DavisDroneClub/gimbal/README.md

# gimbal
Files for 1-axis servo gimbal

* Pictures: Pictures of gimbal for documentation
* cad: Solidworks CAD files for gimbal
* code: Contains Arduino files for gimbal
* gimbal_tester: Contains python script for testing response of gimbal
