DavisDroneClub/gimbal/Pictures/src/README.txt

All flowcharts created on draw.io and saved as .xml file
