DavisDroneClub/gimbal/Pictures/assem/01.png

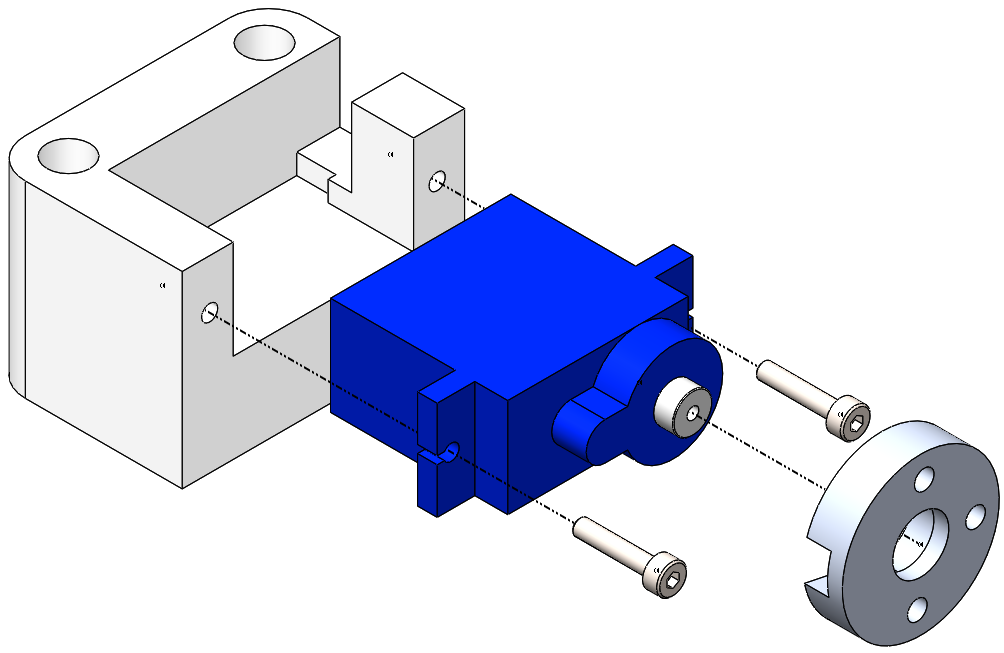
Pictures/assem/01.png
