DavisDroneClub/gimbal/Pictures/assem/02.png

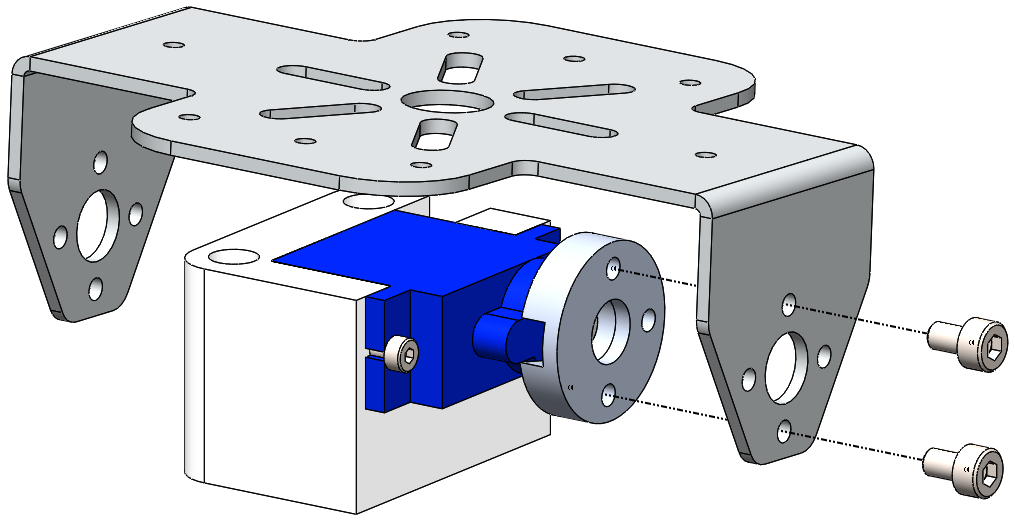
Pictures/assem/02.png
