DavisDroneClub/gimbal/Pictures/assem/03.png

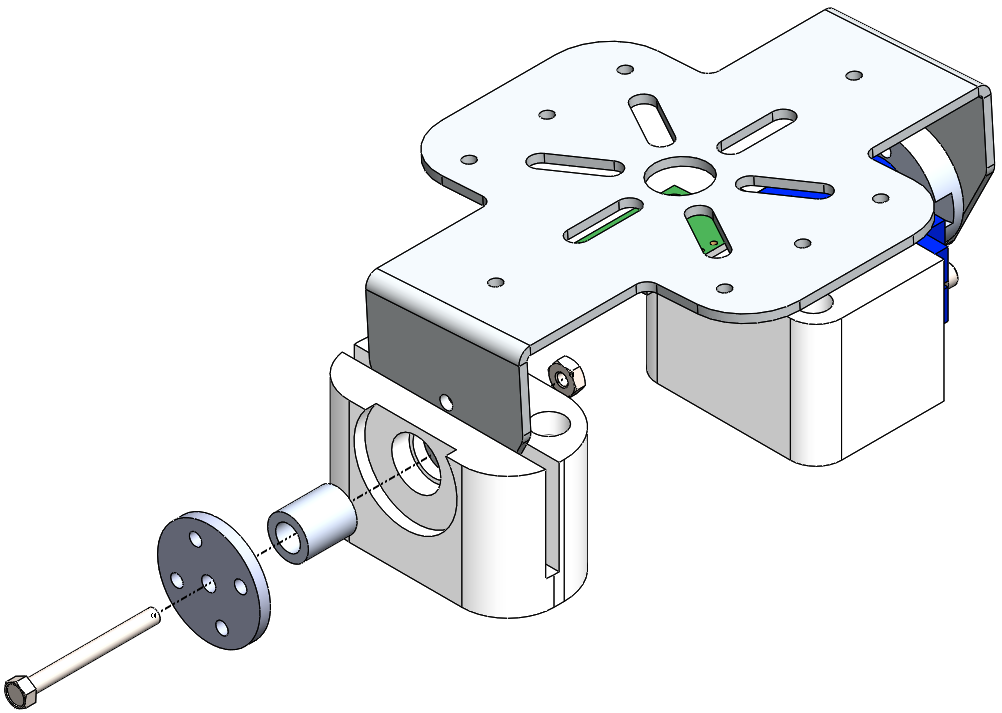
Pictures/assem/03.png
