DavisDroneClub/gimbal/Pictures/assem/04.png

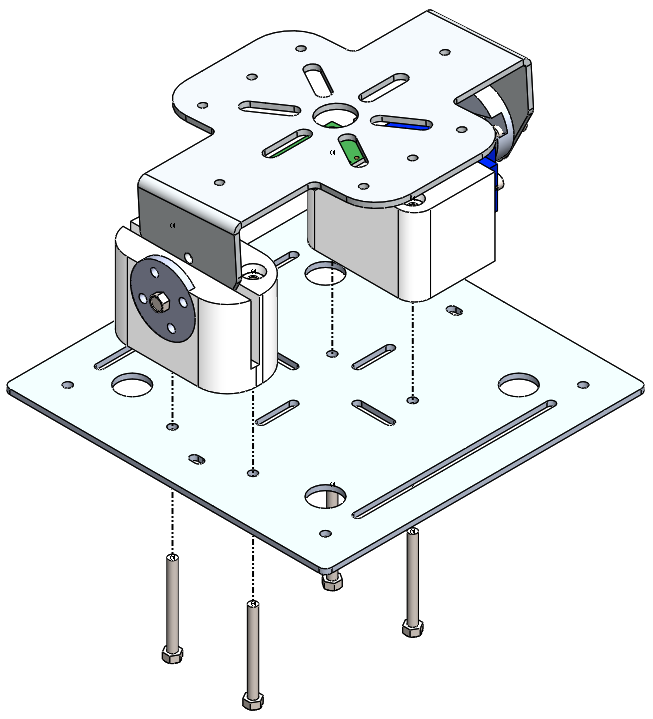
Pictures/assem/04.png
