DavisDroneClub/gimbal/Pictures/assem/05.png

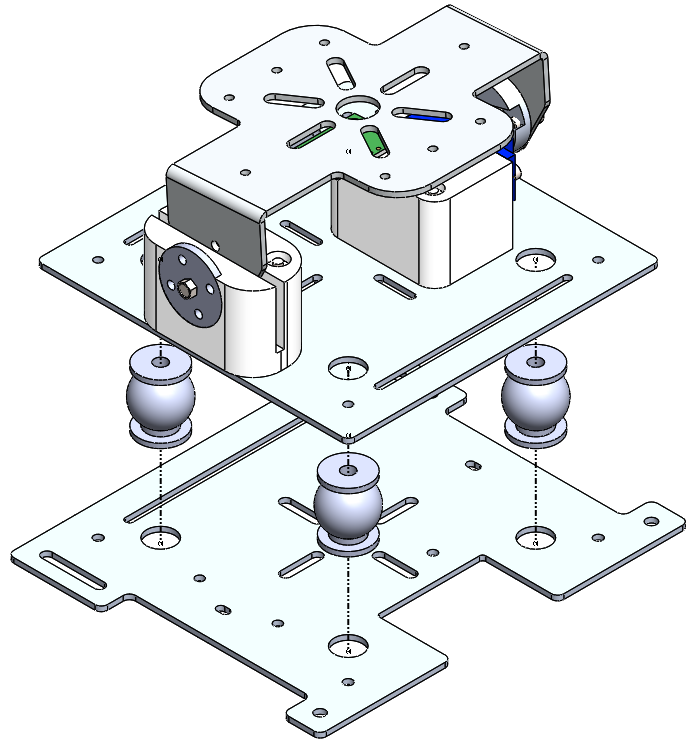
Pictures/assem/05.png
