DavisDroneClub/gimbal/Pictures/assem/06.png

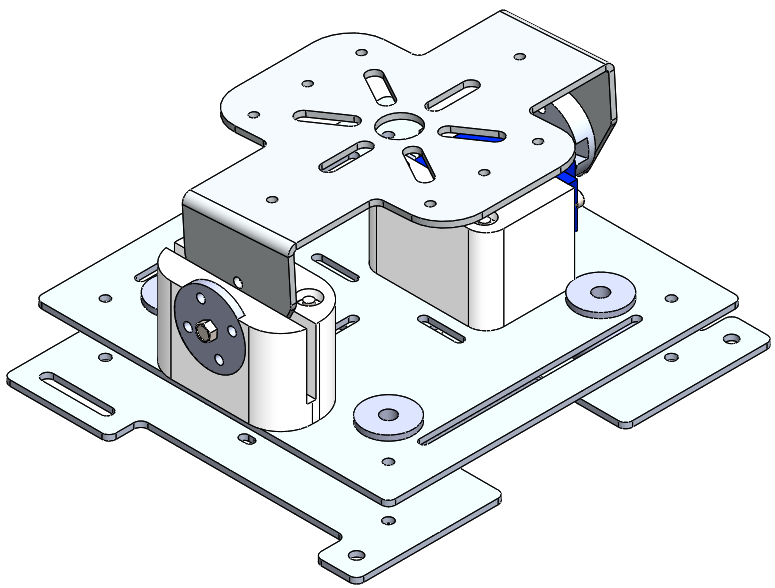
Pictures/assem/06.png
