DavisDroneClub/gimbal/Pictures/imu.jpg

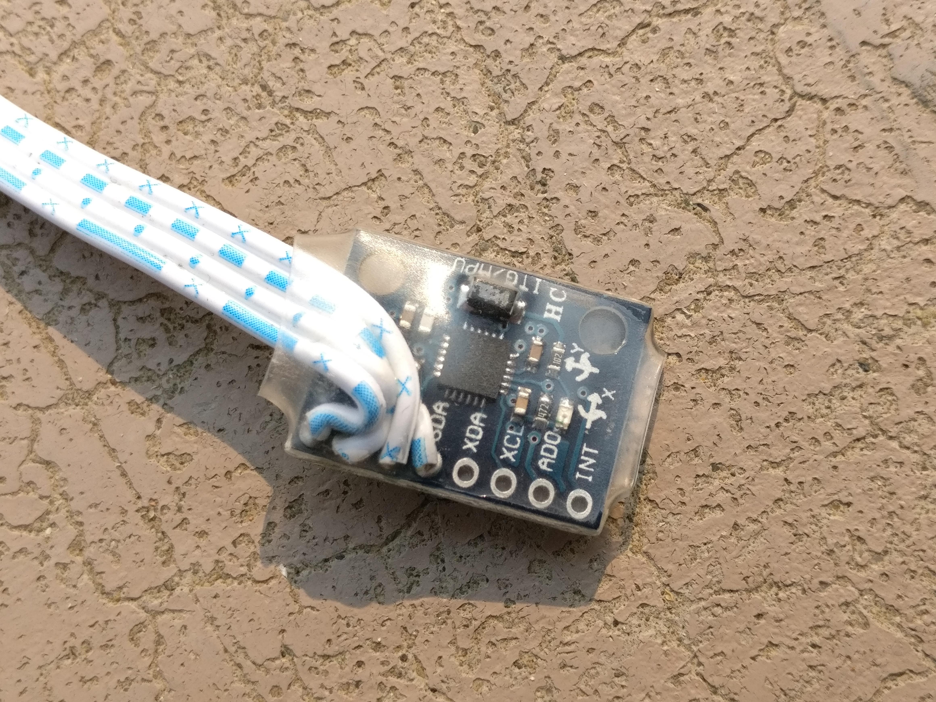
Pictures/imu.jpg
