DavisDroneClub/gimbal/Pictures/imu_mount.jpg

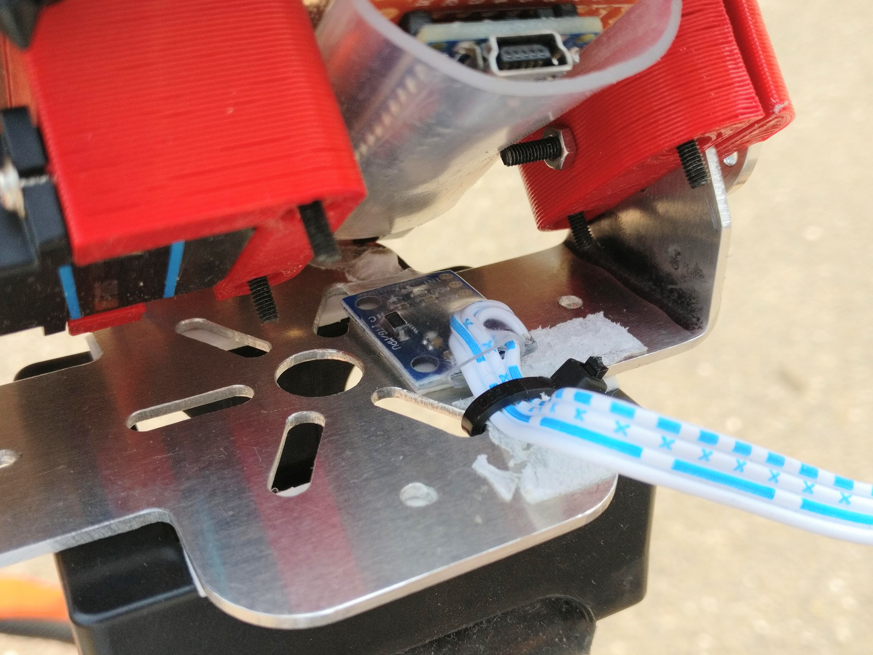
Pictures/imu_mount.jpg
