DavisDroneClub/gimbal/Pictures/upload.png

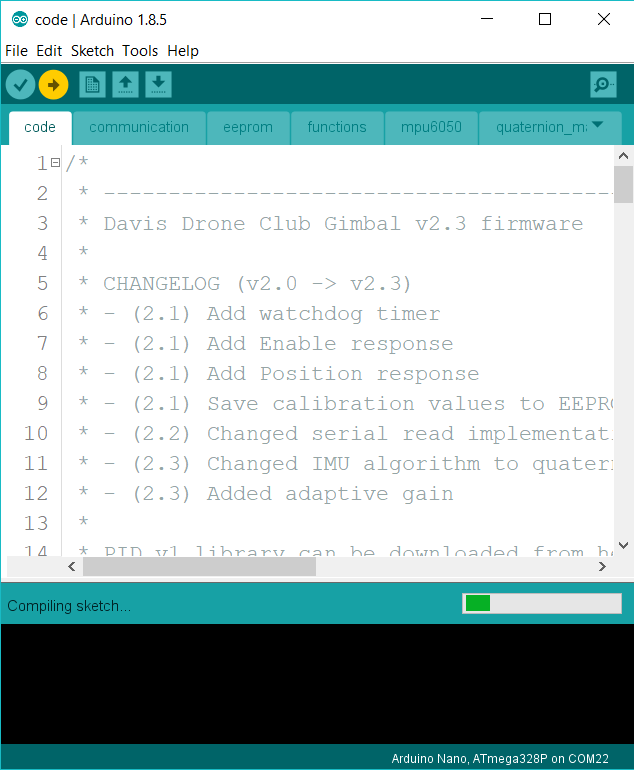
Pictures/upload.png
