DavisDroneClub/gimbal/cad/bom.docx

PART # | DESCRIPTION | QTY.
1 | Axle Block | 1
2 | Servo Assembly | 1
3 | Camera Plate | 1
4 | Servo Horn Screw | 4
5 | Servo Screw | 2
6 | MPU6050 | 1
7 | Aluminium Spacer | 1
8 | M2.5 Nut | 5
9 | M25 x 25 Screw | 5
10 | Gimbal Plate | 1
11 | Servo Wheel | 1
12 | Shock Ball | 4
13 | Matrice Plate | 1
14 | Servo Adapter | 1
15 | Electronics Board | 1
