DavisDroneClub/gimbal/Pictures/bom.png

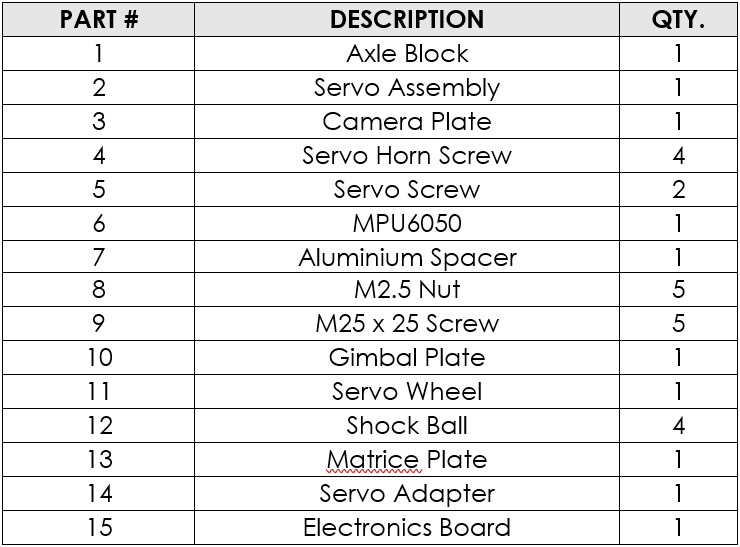
Pictures/bom.png
