DavisDroneClub/gimbal/cad/03-01-servo_assembly.SLDASM

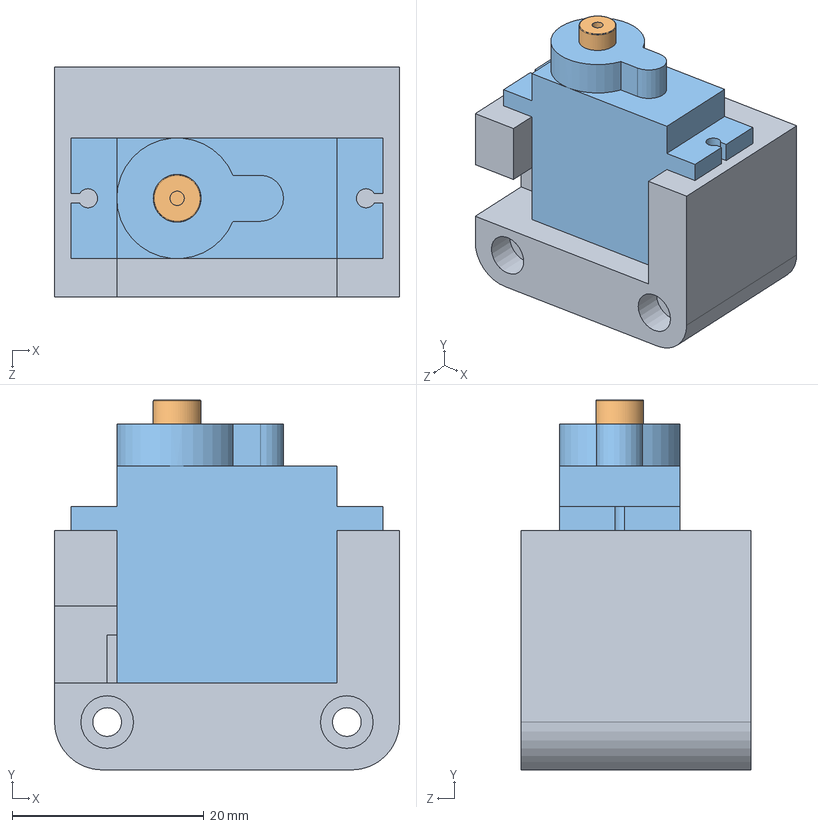
[picture p31: CAD file, 2018-10-07]
cad/03-01-servo_assembly.SLDASM
36.0 x 38.6 x 24.0 mm
03-01-servo_body
03-01-servo_shaft
02-01-servo_block
