DavisDroneClub/gimbal/cad/00-00-gimbal_assembly.SLDASM

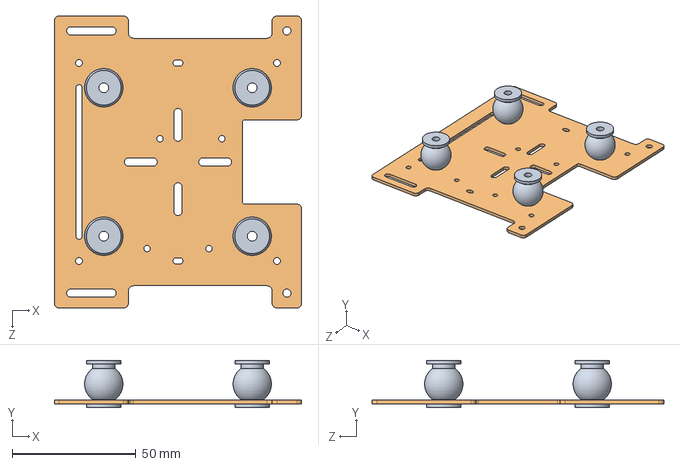
[picture p32: CAD file, 2018-10-07]
cad/00-00-gimbal_assembly.SLDASM
100.0 x 19.0 x 118.0 mm
03-03-shock_ball x 4
01-03-matrice_plate
