DavisDroneClub/gimbal/cad/01-02-gimbal_plate.SLDPRT

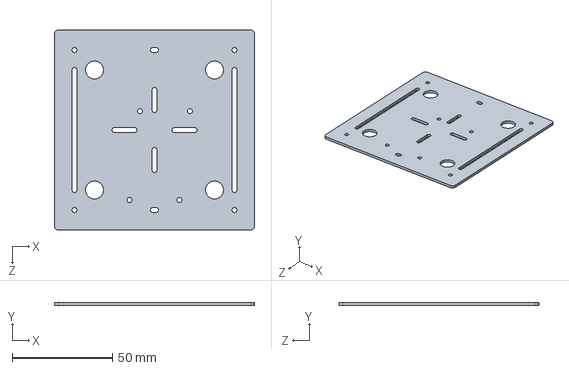
[picture p33: CAD file, 2018-10-07]
cad/01-02-gimbal_plate.SLDPRT
100.0 x 1.59 x 100.0 mm
