DavisDroneClub/gimbal/cad/03-03-shock_ball.SLDPRT

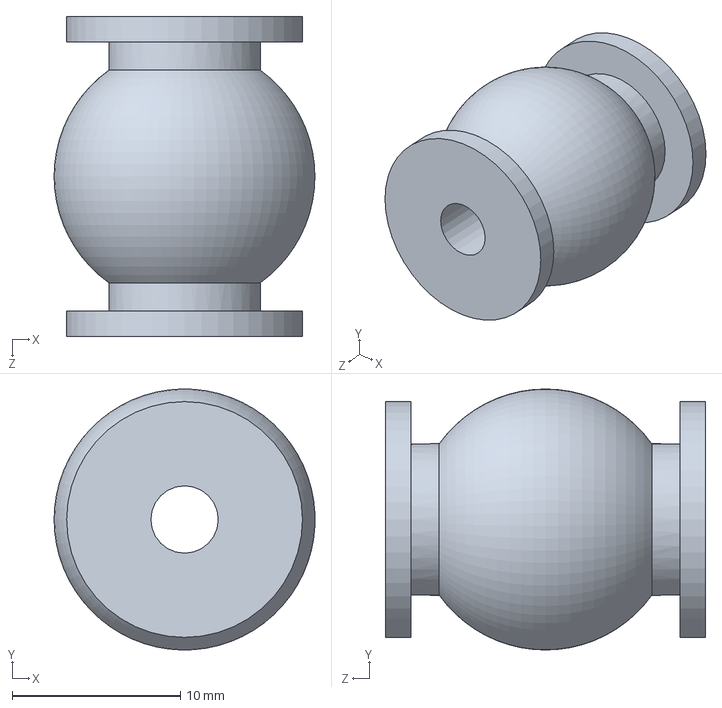
[picture p34: CAD file, 2018-10-07]
cad/03-03-shock_ball.SLDPRT
15.5 x 15.5 x 19.0 mm
