DavisDroneClub/gimbal/cad/03-01-servo_horn.SLDPRT

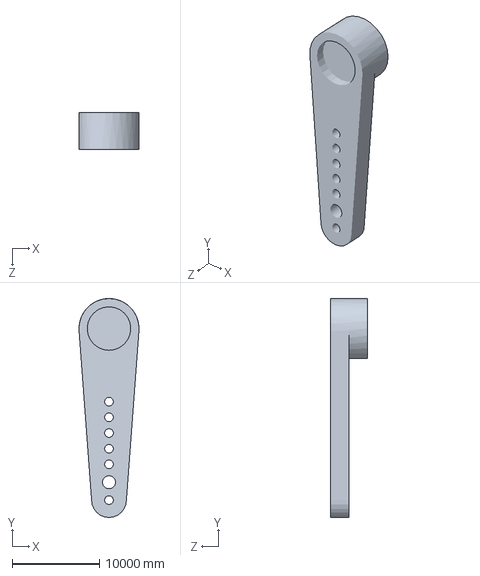
[picture p35: CAD file, 2018-10-07]
cad/03-01-servo_horn.SLDPRT
6900.0 x 25150.0 x 4300.0 mm
