DavisDroneClub/gimbal/cad/Base.SLDPRT

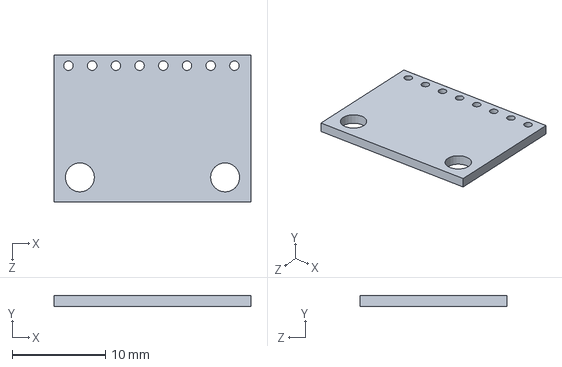
[picture p36: CAD file, 2018-10-07]
cad/Base.SLDPRT
21.1 x 1.14 x 15.7 mm
