DavisDroneClub/gimbal/cad/aluminium_spacer.SLDPRT

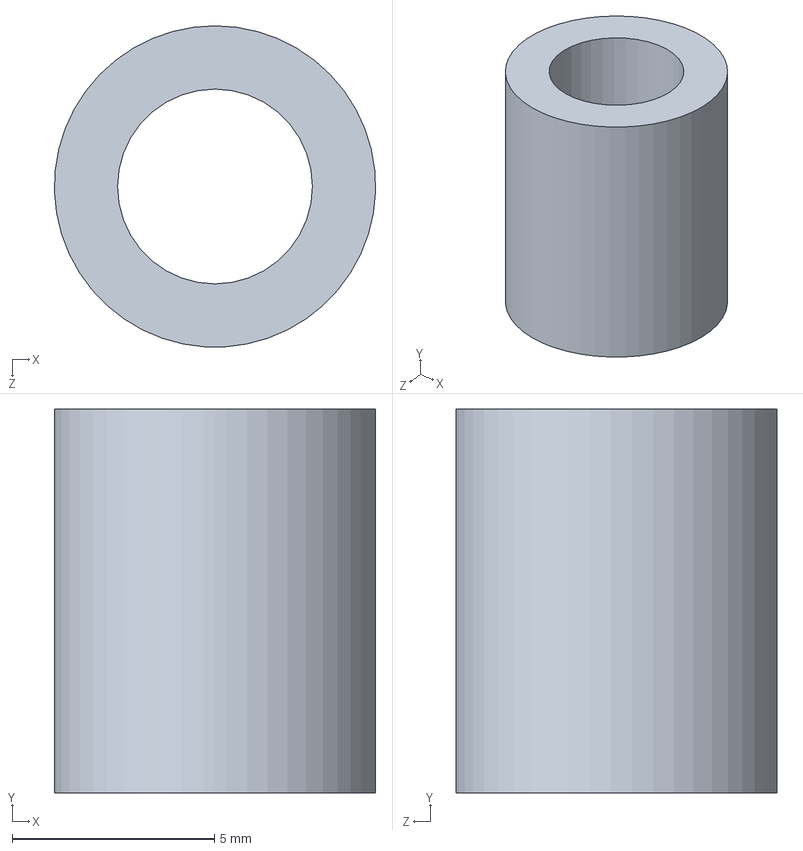
[picture p37: CAD file, 2018-10-07]
cad/aluminium_spacer.SLDPRT
7.95 x 9.50 x 7.95 mm
