DavisDroneClub/gimbal/cad/03-02-servo_wheel.SLDPRT

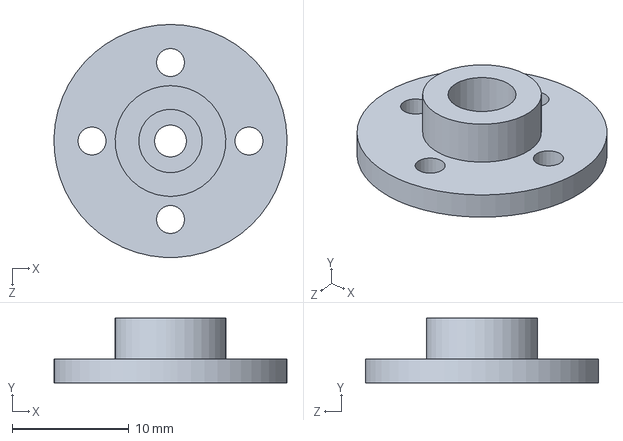
[picture p38: CAD file, 2018-10-07]
cad/03-02-servo_wheel.SLDPRT
20.0 x 5.55 x 20.0 mm
