DavisDroneClub/gimbal/cad/03-01-servo_body.SLDPRT

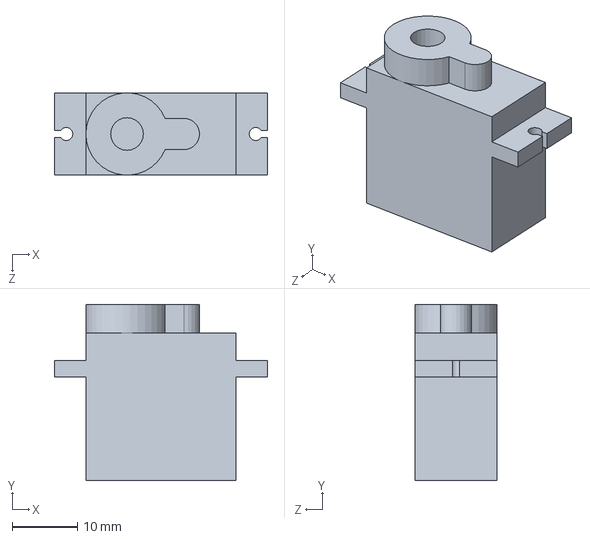
[picture p39: CAD file, 2018-10-07]
cad/03-01-servo_body.SLDPRT
32.6 x 27.0 x 12.6 mm
