DavisDroneClub/gimbal/cad/02-03-servo_adapter.SLDPRT

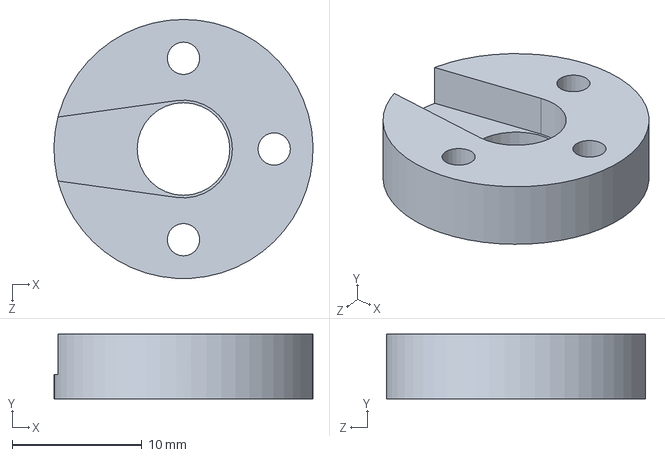
[picture p40: CAD file, 2018-10-07]
cad/02-03-servo_adapter.SLDPRT
20.0 x 5.00 x 20.0 mm
