DavisDroneClub/gimbal/cad/01-01-camera_plate.SLDPRT

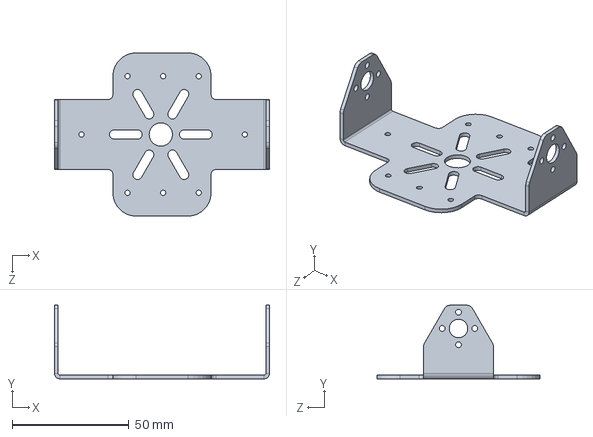
[picture p41: CAD file, 2018-10-07]
cad/01-01-camera_plate.SLDPRT
92.2 x 31.6 x 70.0 mm
