DavisDroneClub/gimbal/cad/03-01-servo_shaft.SLDPRT

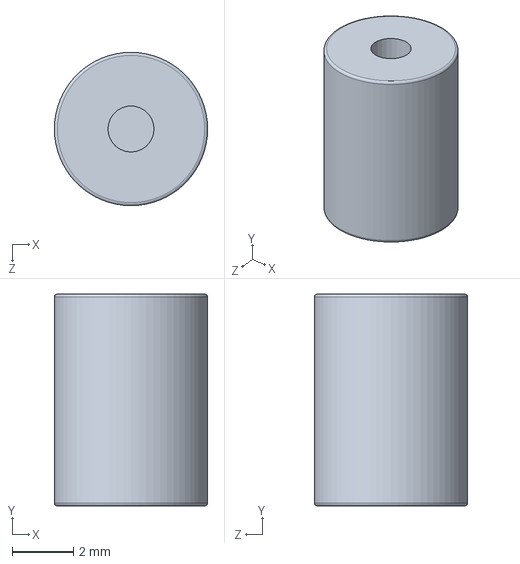
[picture p42: CAD file, 2018-10-07]
cad/03-01-servo_shaft.SLDPRT
4.99 x 6.90 x 4.99 mm
