DavisDroneClub/gimbal/cad/01-03-matrice_plate.SLDPRT

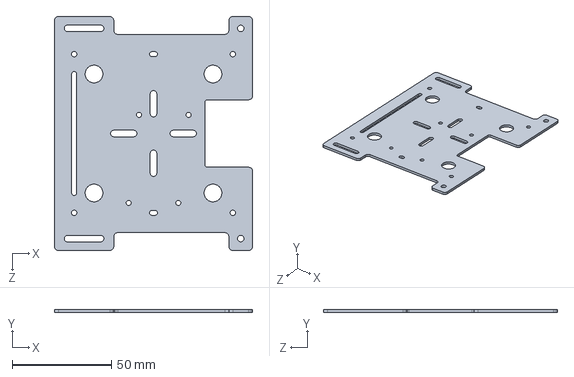
[picture p43: CAD file, 2018-10-07]
cad/01-03-matrice_plate.SLDPRT
100.0 x 1.59 x 118.0 mm
