DavisDroneClub/gimbal/cad/02-01-servo_block.SLDPRT

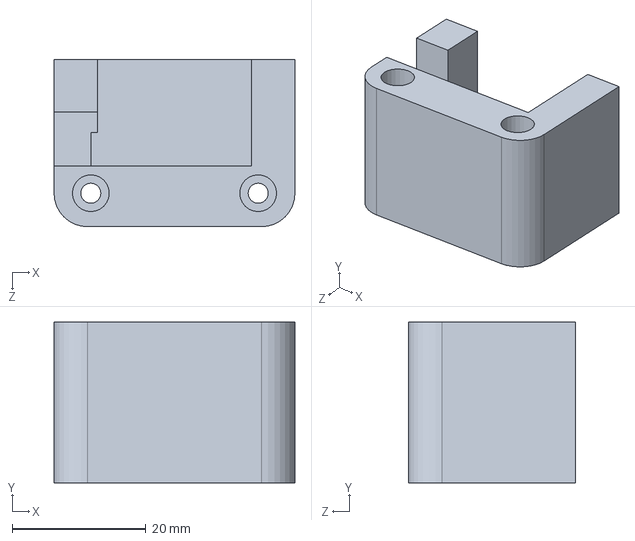
[picture p44: CAD file, 2018-10-07]
cad/02-01-servo_block.SLDPRT
36.0 x 24.0 x 25.0 mm
