DavisDroneClub/gimbal/cad/02-02-axle_block.SLDPRT

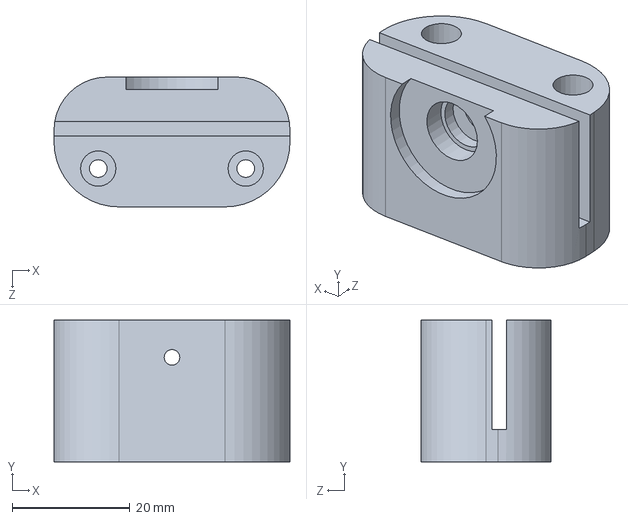
[picture p45: CAD file, 2018-10-07]
cad/02-02-axle_block.SLDPRT
40.0 x 24.0 x 22.0 mm
