DavisDroneClub/gimbal/cad/Resistor small black.SLDPRT

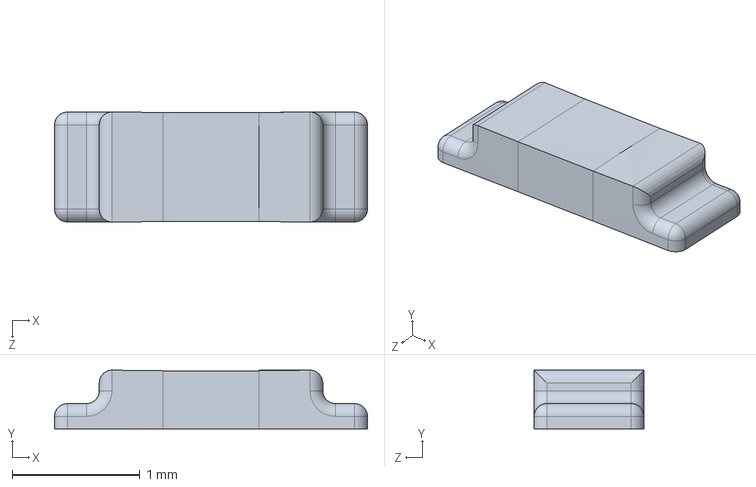
[picture p46: CAD file, 2018-07-04]
cad/Resistor small black.SLDPRT
2.45 x 0.46 x 0.86 mm
