DavisDroneClub/gimbal/cad/sensor chip.SLDPRT

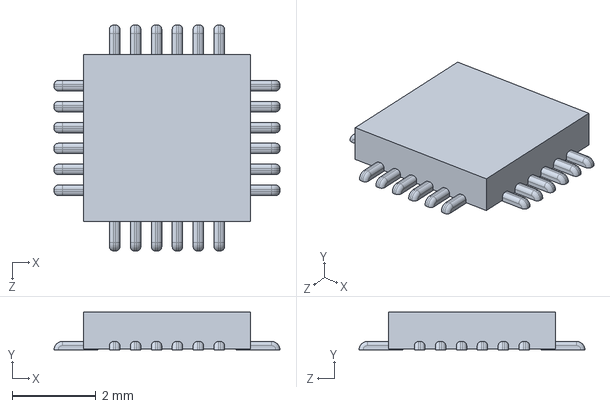
[picture p47: CAD file, 2018-07-04]
cad/sensor chip.SLDPRT
5.40 x 0.9 x 5.40 mm
