DavisDroneClub/gimbal/cad/S2NH chip.SLDPRT

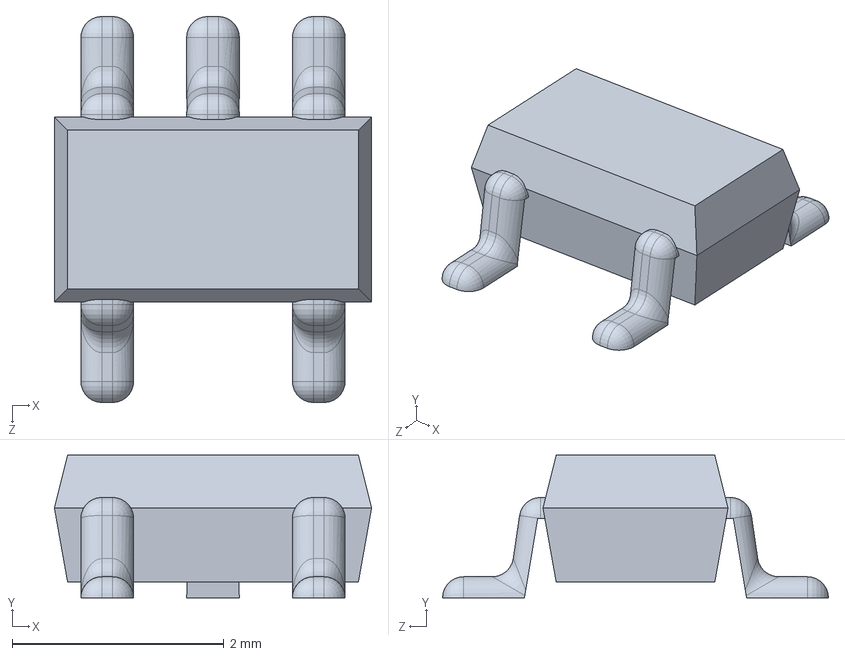
[picture p48: CAD file, 2018-07-04]
cad/S2NH chip.SLDPRT
3.00 x 1.35 x 3.65 mm
