DavisDroneClub/gimbal/cad/Resistor small.SLDPRT

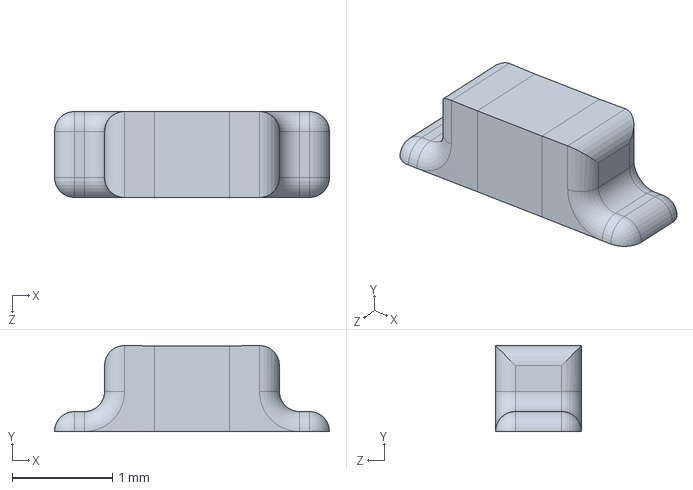
[picture p49: CAD file, 2018-07-04]
cad/Resistor small.SLDPRT
2.75 x 0.86 x 0.86 mm
