DavisDroneClub/gimbal/cad/Small LED.SLDPRT

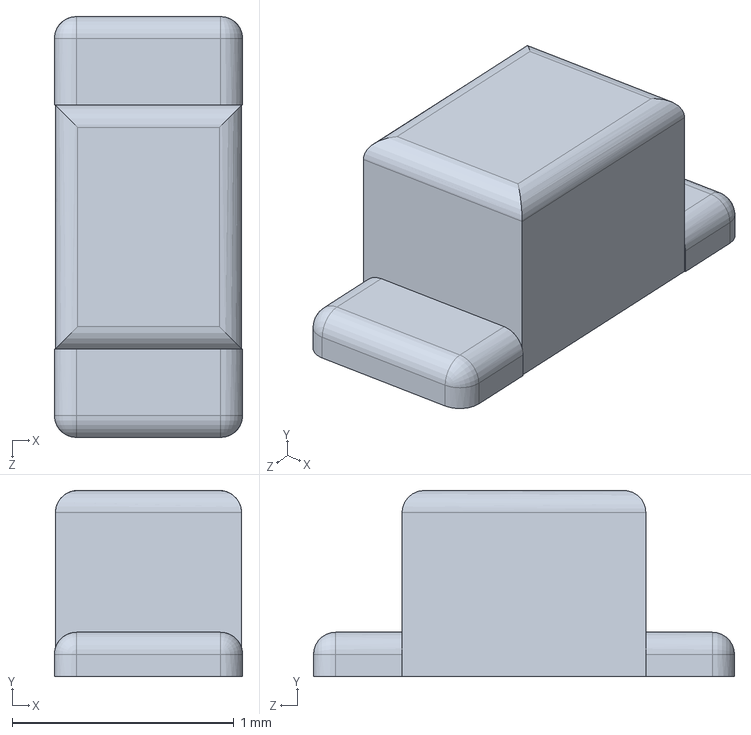
[picture p50: CAD file, 2018-07-04]
cad/Small LED.SLDPRT
0.85 x 0.84 x 1.90 mm
