DavisDroneClub/gimbal/cad/Resistor black.SLDPRT

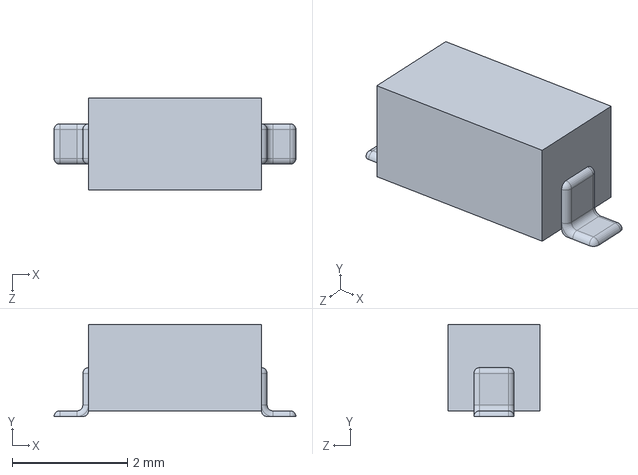
[picture p51: CAD file, 2018-07-04]
cad/Resistor black.SLDPRT
4.20 x 1.60 x 1.60 mm
