DavisDroneClub/gimbal/(list of files, cad)

Other CAD files:
cad/MPU 6050 IMU.SLDASM
cad/02-04-servo_adapter_2.SLDPRT
cad/servo_wheel.SLDPRT
cad/00-00-gimbal_assembly.SLDDRW
cad/cad_archive/Base.SLDPRT
cad/cad_archive/Electronics Board Assembly.SLDASM
cad/cad_archive/HeaderMalePart.SLDPRT
cad/cad_archive/MPU 6050 IMU.SLDASM
cad/cad_archive/User Library-Arduino Nano 3.0.SLDASM
cad/cad_archive/User Library-Arduino Nano 3.0_Arduino Nano 3.0 Bare PCB.SLDPRT
cad/cad_archive/User Library-Arduino Nano 3.0_Capacitor 0805.SLDPRT
cad/cad_archive/User Library-Arduino Nano 3.0_HDR1x15.SLDPRT
cad/cad_archive/User Library-Arduino Nano 3.0_LED 1206 Blue.SLDPRT
cad/cad_archive/User Library-Arduino Nano 3.0_LED 1206 Green.SLDPRT
cad/cad_archive/User Library-Arduino Nano 3.0_LED 1206 Orange.SLDPRT
cad/cad_archive/User Library-Arduino Nano 3.0_LED 1206 RED.SLDPRT
cad/cad_archive/User Library-Arduino Nano 3.0_SOT-223.SLDPRT
cad/cad_archive/User Library-Arduino Nano 3.0_User Library-548190572_USBBMINI_.SLDPRT
cad/cad_archive/User Library-Arduino Nano 3.0_User Library-Array-1206-4Way-Var2-1.sldasm
cad/cad_archive/User Library-Arduino Nano 3.0_User Library-Array-1206-4Way-Var2-1_Anschl_X_FCsse_1.sldprt
cad/cad_archive/User Library-Arduino Nano 3.0_User Library-Array-1206-4Way-Var2-1_Beschriftung_1.sldprt
cad/cad_archive/User Library-Arduino Nano 3.0_User Library-Array-1206-4Way-Var2-1_Deckel_1.sldprt
cad/cad_archive/User Library-Arduino Nano 3.0_User Library-Array-1206-4Way-Var2-1_K_X_F6rper_1.sldprt
cad/cad_archive/User Library-Arduino Nano 3.0_User Library-CSTCE_V-1.sldasm
cad/cad_archive/User Library-Arduino Nano 3.0_User Library-CSTCE_V-1_453330369.sldasm
cad/cad_archive/User Library-Arduino Nano 3.0_User Library-CSTCE_V-1_453331041.sldasm
cad/cad_archive/User Library-Arduino Nano 3.0_User Library-CSTCE_V-1_453331489.sldasm
cad/cad_archive/User Library-Arduino Nano 3.0_User Library-CSTCE_V-1_453557585.sldasm
cad/cad_archive/User Library-Arduino Nano 3.0_User Library-CSTCE_V-1_453562065.sldasm
cad/cad_archive/User Library-Arduino Nano 3.0_User Library-CSTCE_V-1_453562833.sldasm
cad/cad_archive/User Library-Arduino Nano 3.0_User Library-CSTCE_V-1_453563601.sldasm
cad/cad_archive/User Library-Arduino Nano 3.0_User Library-CSTCE_V-1_453563729.sldasm
cad/cad_archive/User Library-Arduino Nano 3.0_User Library-CSTCE_V-1_453563857.sldasm
cad/cad_archive/User Library-Arduino Nano 3.0_User Library-CSTCE_V-1_453563985.sldasm
cad/cad_archive/User Library-Arduino Nano 3.0_User Library-CSTCE_V-1_453565521.sldasm
cad/cad_archive/User Library-Arduino Nano 3.0_User Library-CSTCE_V-1_453565777.sldasm
cad/cad_archive/User Library-Arduino Nano 3.0_User Library-CSTCE_V-1_453565905.sldasm
cad/cad_archive/User Library-Arduino Nano 3.0_User Library-CSTCE_V-1_453566289.sldasm
cad/cad_archive/User Library-Arduino Nano 3.0_User Library-CSTCE_V-1_453566801.sldasm
cad/cad_archive/User Library-Arduino Nano 3.0_User Library-CSTCE_V-1_453567057.sldasm
cad/cad_archive/User Library-Arduino Nano 3.0_User Library-CSTCE_V-1_Board1.sldprt
cad/cad_archive/User Library-Arduino Nano 3.0_User Library-CSTCE_V-1_Cylinder2.sldprt
cad/cad_archive/User Library-Arduino Nano 3.0_User Library-CSTCE_V-1_Cylinder3.sldprt
cad/cad_archive/User Library-Arduino Nano 3.0_User Library-CSTCE_V-1_Extruded13.sldprt
cad/cad_archive/User Library-Arduino Nano 3.0_User Library-CSTCE_V-1_Extruded14.sldprt
cad/cad_archive/User Library-Arduino Nano 3.0_User Library-CSTCE_V-1_Extruded15.sldprt
cad/cad_archive/User Library-Arduino Nano 3.0_User Library-CSTCE_V-1_Extruded16.sldprt
cad/cad_archive/User Library-Arduino Nano 3.0_User Library-CSTCE_V-1_Extruded17.sldprt
cad/cad_archive/User Library-Arduino Nano 3.0_User Library-CSTCE_V-1_Extruded18.sldprt
cad/cad_archive/User Library-Arduino Nano 3.0_User Library-CSTCE_V-1_Extruded19.sldprt
cad/cad_archive/User Library-Arduino Nano 3.0_User Library-CSTCE_V-1_Extruded20.sldprt
cad/cad_archive/User Library-Arduino Nano 3.0_User Library-CSTCE_V-1_Extruded21.sldprt
cad/cad_archive/User Library-Arduino Nano 3.0_User Library-CSTCE_V-1_Extruded22.sldprt
cad/cad_archive/User Library-Arduino Nano 3.0_User Library-CSTCE_V-1_Extruded23.sldprt
cad/cad_archive/User Library-Arduino Nano 3.0_User Library-CSTCE_V-1_Extruded24.sldprt
cad/cad_archive/User Library-Arduino Nano 3.0_User Library-CSTCE_V-1_Extruded25.sldprt
cad/cad_archive/User Library-Arduino Nano 3.0_User Library-CSTCE_V-1_Free-Models1.sldasm
cad/cad_archive/User Library-Arduino Nano 3.0_User Library-CSTCE_V-1_Sphere1.sldprt
cad/cad_archive/User Library-Arduino Nano 3.0_User Library-SSOP-28-FT232RL_.SLDPRT
cad/cad_archive/User Library-Arduino Nano 3.0_User Library-SW3dPS-atmega8 (tqfp32)_V2008_.SLDPRT
cad/cad_archive/User Library-Arduino Nano 3.0_User Library-TUMD2.sldasm
cad/cad_archive/User Library-Arduino Nano 3.0_User Library-TUMD2_675155360.sldasm
cad/cad_archive/User Library-Arduino Nano 3.0_User Library-TUMD2_676056384.sldasm
cad/cad_archive/User Library-Arduino Nano 3.0_User Library-TUMD2_702825728.sldasm
cad/cad_archive/User Library-Arduino Nano 3.0_User Library-TUMD2_702828800.sldasm
cad/cad_archive/User Library-Arduino Nano 3.0_User Library-TUMD2_BASE.sldasm
cad/cad_archive/User Library-Arduino Nano 3.0_User Library-TUMD2_BODY_L.sldasm
cad/cad_archive/User Library-Arduino Nano 3.0_User Library-TUMD2_BODY_S.sldasm
cad/cad_archive/User Library-Arduino Nano 3.0_User Library-TUMD2_Extruded.sldprt
cad/cad_archive/User Library-Arduino Nano 3.0_User Library-TUMD2_Extruded_2.sldprt
cad/cad_archive/User Library-Arduino Nano 3.0_User Library-TUMD2_Extruded_3.sldprt
cad/cad_archive/User Library-Arduino Nano 3.0_User Library-TUMD2_Extruded_4.sldprt
cad/cad_archive/User Library-Arduino Nano 3.0_User Library-TUMD2_Extruded_5.sldprt
cad/cad_archive/User Library-Arduino Nano 3.0_User Library-TUMD2_Extruded_6.sldprt
cad/cad_archive/User Library-Arduino Nano 3.0_User Library-TUMD2_Extruded_7.sldprt
cad/cad_archive/User Library-Arduino Nano 3.0_User Library-TUMD2_Free-Models.sldasm
cad/cad_archive/User Library-Arduino Nano 3.0_User Library-Tantalum Capacitor Case R.SLDASM
cad/cad_archive/User Library-Arduino Nano 3.0_User Library-Tantalum Capacitor Case R_Tantalum case R part1.SLDPRT
cad/cad_archive/User Library-Arduino Nano 3.0_User Library-Tantalum Capacitor Case R_Tantalum case R part2.SLDPRT
cad/cad_archive/aluminium_spacer.SLDPRT
cad/cad_archive/axle block.SLDPRT
cad/cad_archive/base plate.SLDPRT
cad/cad_archive/camera mounting plate.SLDPRT
cad/cad_archive/expansion bay base.SLDPRT
cad/cad_archive/expansion bay.SLDASM
cad/cad_archive/expansion bracket.SLDPRT
cad/cad_archive/gimbal assembly.SLDASM
cad/cad_archive/matrice_plate_v2.SLDPRT
cad/cad_archive/nylon standoff.SLDPRT
cad/cad_archive/perforated board.SLDPRT
cad/cad_archive/servo body.SLDPRT
cad/cad_archive/servo holder.SLDPRT
cad/cad_archive/servo wheel.SLDPRT
cad/cad_archive/servo.SLDASM
cad/cad_archive/servo_wheel.SLDPRT
cad/cad_archive/shock ball.SLDPRT
