DavisDroneClub/gimbal/Pictures/00-00-gimbal_assembly.PNG

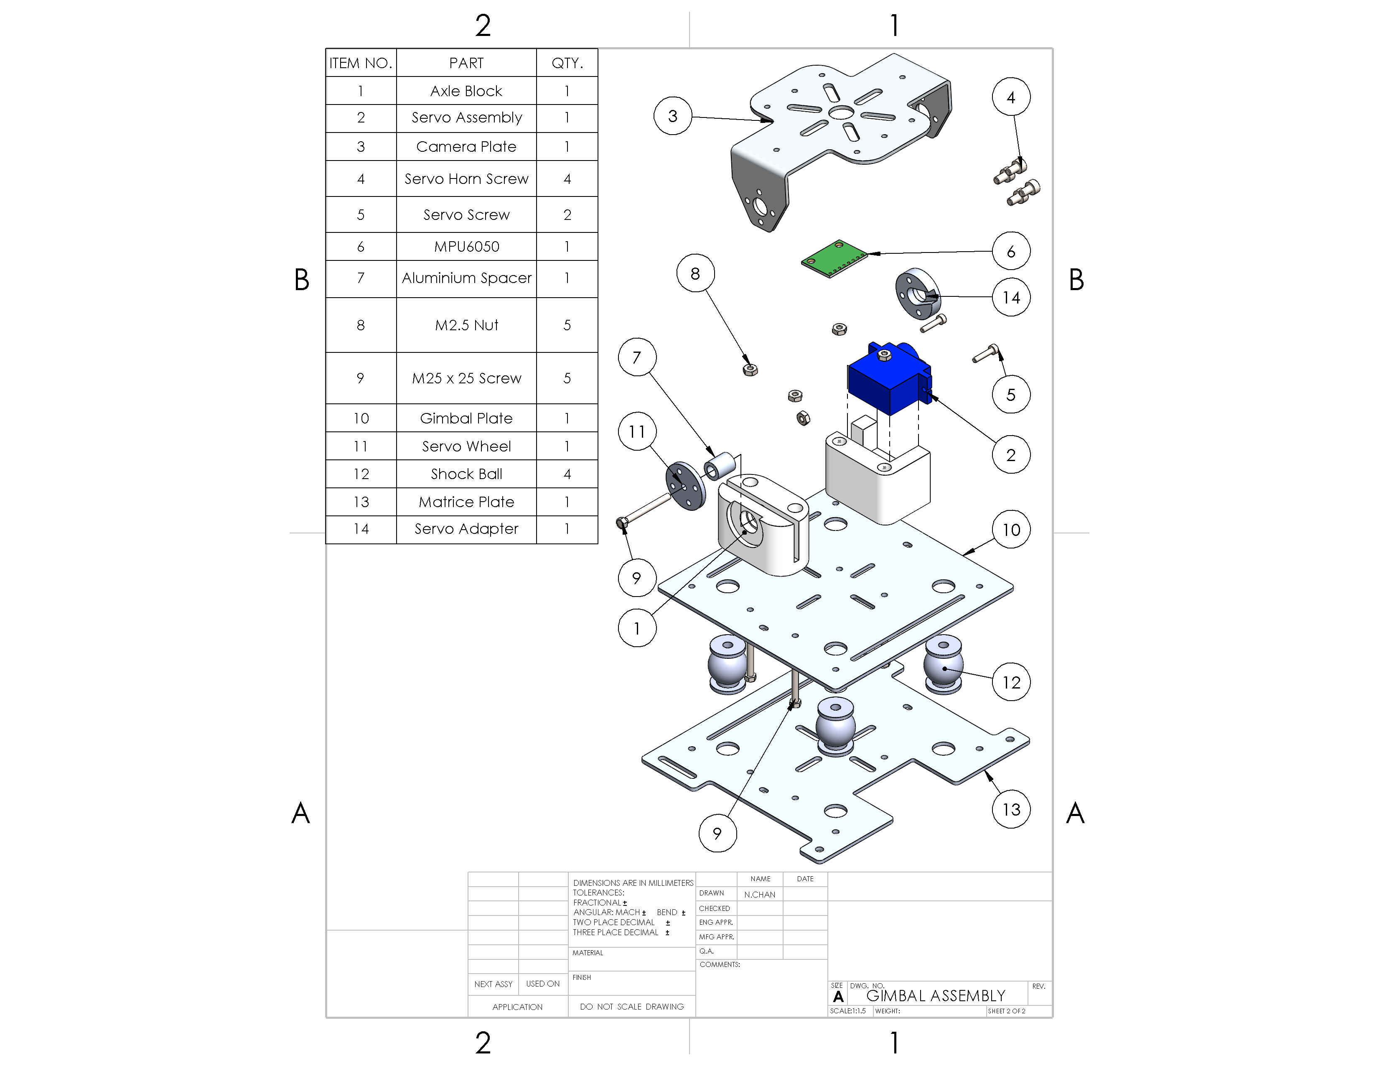
Pictures/00-00-gimbal_assembly.PNG
