DavisDroneClub/gimbal/Tests/quaternion_tests.xlsx

Sheet: Sheet1
114582 | 0.14 | 0.01 | BASE_GAIN | 0.02
114587 | 0.16 | 0.03 | THRESH_LOW | 0.05
114591 | 0.17 | 0.04 | THRESH_HIGH | 0.1
114596 | 0.2 | 0.06 | EPSILON | 0.9
114600 | 0.2 | 0.07
114606 | 0.22 | 0.09
114610 | 0.23 | 0.1
114615 | 0.25 | 0.12
114620 | 0.26 | 0.13
114624 | 0.27 | 0.15
114629 | 0.29 | 0.16
114633 | 0.3 | 0.17
114638 | 0.32 | 0.19
114642 | 0.33 | 0.2
114648 | 0.34 | 0.22
114653 | 0.35 | 0.23
114657 | 0.37 | 0.24
114662 | 0.38 | 0.26
114666 | 0.4 | 0.27
114671 | 0.41 | 0.29
114676 | 0.42 | 0.3
114680 | 0.43 | 0.31
114685 | 0.44 | 0.32
114690 | 0.46 | 0.33
114695 | 0.46 | 0.34
114699 | 0.47 | 0.35
114704 | 0.48 | 0.36
114709 | 0.49 | 0.37
114713 | 0.49 | 0.37
114718 | 0.51 | 0.39
114722 | 0.51 | 0.39
114727 | 0.52 | 0.4
114733 | 0.53 | 0.41
114737 | 0.54 | 0.42
114742 | 0.55 | 0.43
114746 | 0.56 | 0.44
114751 | 0.57 | 0.45
114755 | 0.59 | 0.47
114760 | 0.6 | 0.48
114765 | 0.6 | 0.48
114769 | 0.59 | 0.48
114775 | 0.59 | 0.48
114779 | 0.61 | 0.49
114784 | 0.61 | 0.49
114789 | 0.61 | 0.5
114793 | 0.62 | 0.51
114798 | 0.63 | 0.51
114802 | 0.63 | 0.52
114807 | 0.64 | 0.53
114812 | 0.65 | 0.54
114817 | 0.65 | 0.53
114822 | 0.65 | 0.54
114826 | 0.67 | 0.56
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
