DavisDroneClub/gimbal/Tests/plots/0.02-0.05-0.1-0.9.png

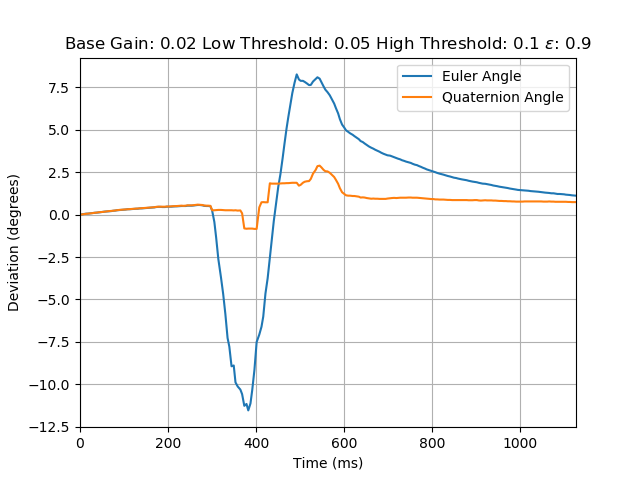
Tests/plots/0.02-0.05-0.1-0.9.png
