DavisDroneClub/gimbal/cad/00-00-gimbal_assembly.PDF

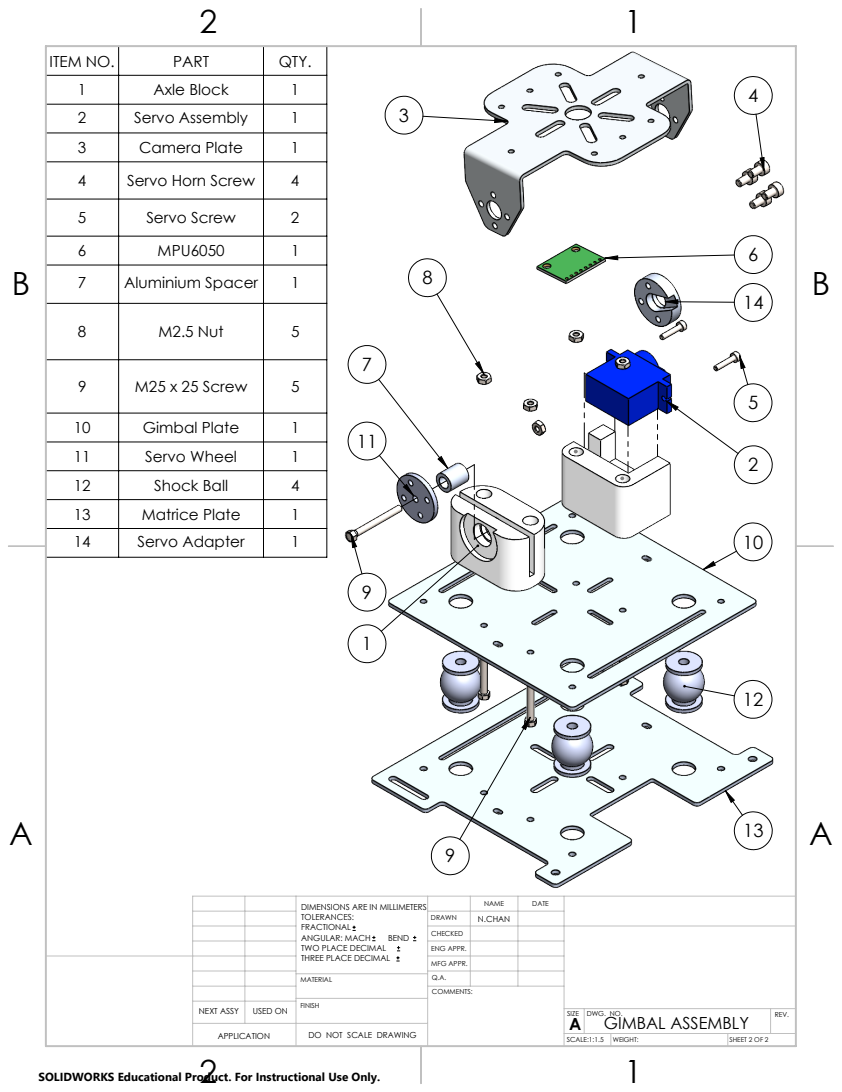
[picture p64: page 1]

ITEM NO. | PART | QTY.
1 | Axle Block | 1
2 | Servo Assembly | 1
3 | Camera Plate | 1
4 | Servo Horn Screw | 4
5 | Servo Screw | 2
6 | MPU6050 | 1
7 | Aluminium Spacer | 1

8 | M2.5 Nut | 5

9 | M25 x 25 Screw | 5

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

TOLERANCES: FRACTIONAL ANGULAR: MACH BEND TWO PLACE DECIMAL THREE PLACE DECIMAL | | NAME | DATE DIMENSIONS ARE IN MILLIMETERS

DRAWN | N.CHAN
CHECKED
ENG APPR.
MFG APPR.

MATERIAL | Q.A.

NEXT ASSY | USED ON | FINISH

SIZE A | DWG. NO. GIMBAL ASSEMBLY | REV.

APPLICATION | | DO NOT SCALE DRAWING

SCALE:1:1.5 | WEIGHT: | SHEET 2 OF 2

SOLIDWORKS Educational Product. For Instructional Use Only.
