DavisDroneClub/gimbal/code/code.ino

/*
 * ----------------------------------------------------------------------
 * Davis Drone Club Gimbal v2.3 firmware
 * 
 * CHANGELOG (v2.0 -> v2.3)
 * - (2.1) Add watchdog timer
 * - (2.1) Add Enable response
 * - (2.1) Add Position response
 * - (2.1) Save calibration values to EEPROM
 * - (2.2) Changed serial read implementation to non-blocking
 * - (2.3) Changed to quaternion IMU processing
 * - (2.3) Increased loop duration
 * - (2.3) Implemented adaptive gains
 * PID_v1 library can be downloaded from here: https://github.com/br3ttb/Arduino-PID-Library
 * 
 * --------------------ADJUSTABLE SETTINGS--------------------
 */
//PID CONTROLLER DIRECTION: 0 FOR INVERTED, 1 FOR REGULAR
boolean gimbalDir = 1;

//PRINT DATA TO SERIAL: true FOR ENABLED, false FOR DISABLE 
boolean print_en = true;

//Quaternion Filter Variables
double BASE_GAIN = 0.017;
double THRESH_LOW = 0.05;
double THRESH_HIGH = 0.1;
double EPSILON = 0.8;

/*
 * --------------------VARIABLE DECLARATIONS------------------
 */
//Include libraries
#include <Wire.h>
#include <PID_v1.h>
#include <Servo.h>
#include <EEPROM.h>
#include <avr/wdt.h>

//Version here
int VERSION[] = {2,3};

//Declare a union datatype to allow easy conversion between float and byte
//More information on union: https://www.tutorialspoint.com/cprogramming/c_unions.htm
union EEPOMvals {               //Define variables stored in EEPROM
  float  val_float;
  byte   val_byte[4];
} kp, ki, kd, deadband, gyro_x_cal, gyro_y_cal, gyro_z_cal;

//Declaring global variables for IMU and angle calculations
double acc[3], gyro[3], gyro_cal[3];
double acc_cal;
int temp;

float loop_timer;
int  loop_duration;
int  loop_counter;

//Quaternion Math Variables
double identity[] = {1,0,0,0};
double omega;
double INTERVAL = 0.0055555;
double gyro_raw_q[4];
double err_mag;
double alpha;
double q_i[] = {1,0,0,0};
double prev_q[] = {1,0,0,0};
double curr_q;
double rate_gyro_global[4];
double gyro_q[4];
double gyro_R[3][3];
double g_predict[3];
double d_q_acc[4];
double d_acc_interp[4];
double q_out[4];
unsigned long prev_time, delta;
double yaw, pitch, roll;
double test[] = {1,2,3,4};
double test_R[3][3];

//Declaring strings for Serial communication

char input_buf[80];

int delimIndex;                 //Index of delimiter within string
String tuneP = "TUNEP";         //Header content for tuning packet
String tuneI = "TUNEI";         //Header content for tuning packet
String tuneD = "TUNED";         //Header content for tuning packet
String spStr = "SETSP";         //Header content for setpoint packet
String dbStr = "SETDB";         //Header content for deadband packet
String drStr = "SETDR";         //Header content for direction packet
String ptStr = "SETPT";         //Header content for print packet
String enStr = "SETEN";         //Header content for enable packet
String poStr = "SETPO";         //Header content for position set packet
String cbStr = "CALGY";         //Header content for calibrate gyro packet
String peStr = "GETEP";         //Header content to get EEPROM data
String veStr = "GETVE";         //Header content to get version number
String dnStr = "GETDN";         //Header content to get device name
String warnString = "WARN";     //Warning header
String loopString = "LOOP";     //Loop warning header
String dataString = "DATA";     //Data header
String eeprString = "EEPR";     //EEPROM header
String versString = "VERS";     //Version header
String devnString = "DEVN";     //Device name header
String headDelim  = ";";        //Header delimiter
String dataDelim  = ",";        //Data delimiter

//Declaring servo object
Servo servo;

//Declare PID values
double input, setpoint, output;
PID myPID(&input, &output, &setpoint, kp.val_float, ki.val_float, kd.val_float, DIRECT);
#define HIGH_BOUND  130
#define LOW_BOUND   50

/*
 * --------------------SETUP FUNCTION--------------------
 */
void setup() {
  cal_mpu();
  wdt_setup();                    //Setup watchdog timer
  readVals();                     //Read PID values from EEPROM
  myPID.SetTunings(kp.val_float, ki.val_float, kd.val_float);
  init_comm();                    //Initialize I2C and Serial communication
  pinMode(13, OUTPUT);            //Set pinmode of LED pin to output
  init_servo();                   //Initialize servo motor
  delay(1000);                    //Delay to allow gimbal to settle
  init_mpu();                     //Initialize MPU6050
  digitalWrite(13, HIGH);         //Turn on LED
  setpoint = 0;                   //Set PID setpoint and initial output
  output = 90;                    
  myPID.SetOutputLimits(LOW_BOUND,HIGH_BOUND);  //Set output limits of PID controller
  myPID.SetMode(AUTOMATIC);       //Activate PID controller by setting to AUTOMATIC
  myPID.SetControllerDirection(gimbalDir);  //Set mounting direction
  
  digitalWrite(13, LOW);          //Turn off LED after initialization
  loop_timer = micros();          //Initialize loop timer
  loop_counter = 0;
}

/*
 * --------------------LOOP FUNCTION---------------------
*/
void loop() {
  read_mpu();                     //Read data
  process_mpu();                  //Process data
  input = roll;                   //Input into PID loop
  myPID.Compute();                //Compute output

  actuate();                      //Actuate gimbal and deadband

  //Print data to serial if PRINT is enabled
  if(print_en & ((loop_counter%30)==0)) printData(roll, millis());

  checkSerial();                  //Check for serial commands
  enforceLoop();                  //Enforce loop timer
  loop_counter++;
  wdt_reset();
}
