DavisDroneClub/gimbal/(commit log)

2018-05-11 Gimbal Tester Initial Commit
    Moved from Testing/heartbeat
    [data.csv]
2018-07-04 V2.0
    v2.0 Update:
    -Restructured code for readability
    -EEPROM integration
    -Documentation
    [Base.SLDPRT, Electronics Board Assembly.SLDASM, HeaderMalePart.SLDPRT, MPU 6050 IMU.SLDASM, Resistor black.SLDPRT, Resistor small black.SLDPRT, Resistor small.SLDPRT, S2NH chip.SLDPRT]
2018-08-01 v2.3 CAD
    - Renamed files to be more descriptive
    - Added shock mounts and dual plate design
    [00-00-gimbal_assembly.SLDASM, 01-01-camera_plate.SLDPRT, 01-02-gimbal_plate.SLDPRT, 01-03-matrice_plate.SLDPRT, 02-01-servo_block.SLDPRT, 02-02-axle_block.SLDPRT, 02-03-servo_adapter.SLDPRT, 02-04-servo_adapter_2.SLDPRT]
2018-08-01 Revert "GUI v1.0"
    This reverts commit aa3af0c06b71665ba60f8e7e7e3c803e5eca97d6.
    [app.py, code.ino, gimbal.py, tester.py]
2018-08-01 Documentation v1
    [0.01-0.05-0.1-0.9.csv, 0.015-0.05-0.1-0.9.csv, 0.017-0.025-0.075-0.9.csv, 0.017-0.05-0.1-0.7.csv, 0.017-0.05-0.1-0.8.csv, 0.017-0.05-0.1-0.9.csv, 0.017-0.1-0.2-0.9.csv, 0.02-0.05-0.1-0.9.csv]
2018-10-07 documentation updates
    [00-00-gimbal_assembly.SLDASM, 00-00-gimbal_assembly.SLDDRW, 01-01-camera_plate.SLDPRT, 01-02-gimbal_plate.SLDPRT, 01-03-matrice_plate.SLDPRT, 02-01-servo_block.SLDPRT, 02-02-axle_block.SLDPRT, 02-03-servo_adapter.SLDPRT]
